makeyes2/PPM-ECE455-SP26/SP26_Magnetometer1_CoilDesignFiles_TylerFisher/SP26_Magnetometer1_CoilCalculations_TylerFisher.xlsx

Sheet: Solenoid
Input Values: |  | Constants |  | Intermediate Values
 |  |  |  |  | Manuf Estimate: | Theoretical:
Wire Radius (m) | 0.00064 | Copper Resistivity | 1.73e-08 | Coil Resistance | 8.33 | 8.33
Num Turns (theoretical) | 795.7747155 | Madison Larmor Frequency | 2273.68 | Solenoid Volume | 0.001767145868
Solenoid Length (m) | 0.225 | Mu Naught | 1.25663e-06 | Filling Factor of Solenoid | 0.7293835486
Solenoid Rad (m) | 0.05 | Chi Value DI Water | 4.015e-09 | Length of (1) Coil Wire (m) | 250
Voltage | 60
Bandwidth | 200
Outputs Values:
Signal Strength (V) |  | 9.420135823e-07
Signal Noise (V) |  | 5.265349561e-09
S/N Ratio |  | 178.91

Sheet: Toroid
Input Values: |  | Constants |  | Intermediate Values
Wire Radius (m) |  | Copper Resistivity | 1.73e-08 | Coil Resistance | 9.53 | ROUGH ESTIM | 18 gauge
Num Turns | 5000 | Madison Larmor Frequency | 2273.68 | Toroid Volume (mL) | 1542.125688
Toroid L Diam | 0.25 | Mu Naught | 1.25663e-06
Toroid Cros Rad | 0.03 | Chi Value DI Water | 4.015e-09 | Length of Wire Coil Approx (m) | 942.4777961
Voltage | 12 | Magnetic Moment Proton | 1.410606795e-26 | Protons per cubic meter | 6.65336e+28
Bandwidth | 200 | Boltzman's Constant | 1.38e-23
Toroid Wall Wid | 0.005 | Water Fluid Density (kg/m3) | 1000
Fluid Temp (K) | 293 | Water Atomic Weight (amu) | 18
Outputs Values:
Signal Strength |  | 9.325829573e-07 | Actual strength is * (2 - sin^2 alpha), this is assuming best case angle
Signal Noise |  | 5.632785527e-09
S/N Ratio |  | 165.56
