makeyes2/PPM-ECE455-SP26/SP26_Magnetometer1_CoilDesignFiles_TylerFisher/SP26_Magnetometer1_ExtraPlateSTL_TylerFisher.stl

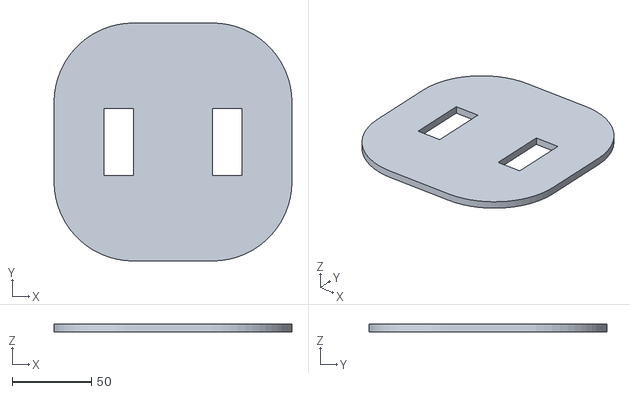
[picture p2: CAD file, 2026-05-05]
SP26_Magnetometer1_CoilDesignFiles_TylerFisher/SP26_Magnetometer1_ExtraPlateSTL_TylerFisher.stl
150.0 x 150.0 x 5.00
