makeyes2/PPM-ECE455-SP26/SP26_Magnetometer1_CoilDesignFiles_TylerFisher/SP26_Magnetometer1_TorusSTL_TylerFisher.stl

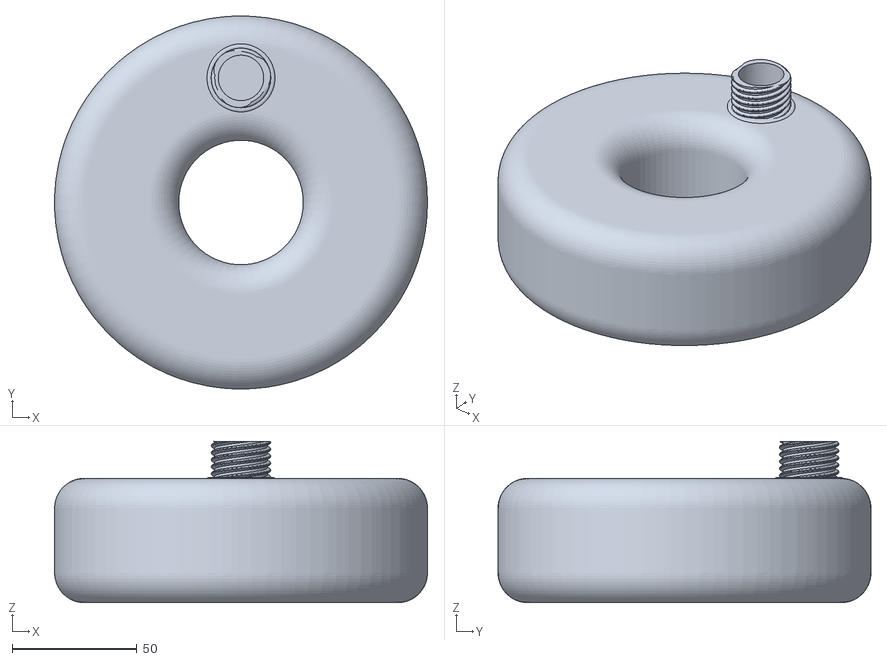
[picture p3: CAD file, 2026-05-05]
SP26_Magnetometer1_CoilDesignFiles_TylerFisher/SP26_Magnetometer1_TorusSTL_TylerFisher.stl
149.7 x 149.7 x 64.8
