makeyes2/PPM-ECE455-SP26/SP26_Magnetometer1_CoilDesignFiles_TylerFisher/SP26_Magnetometer1_ExtraBaseplateSTL_TylerFisher.stl

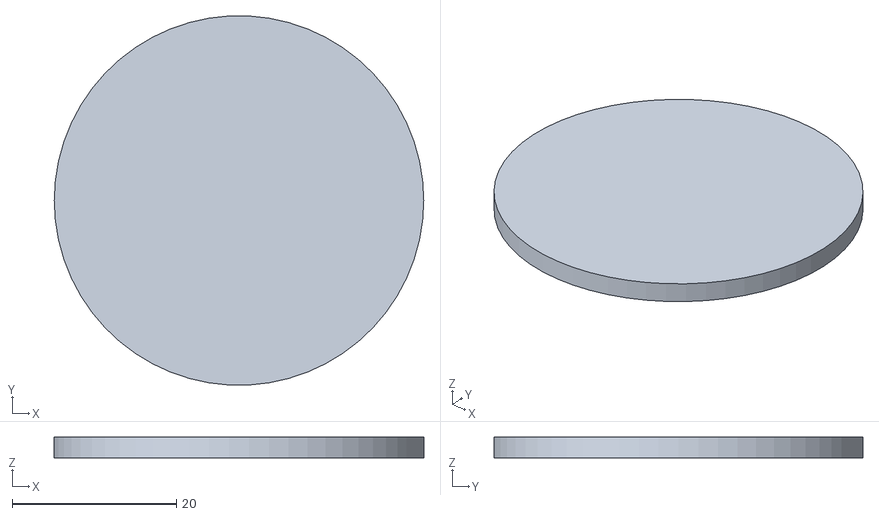
[picture p4: CAD file, 2026-05-05]
SP26_Magnetometer1_CoilDesignFiles_TylerFisher/SP26_Magnetometer1_ExtraBaseplateSTL_TylerFisher.stl
45.0 x 44.9 x 2.50
