makeyes2/PPM-ECE455-SP26/SP26_Magnetometer1_CoilDesignFiles_TylerFisher/SP26_Magnetometer1_PolarizationCoilandBase_TylerFisher.stl

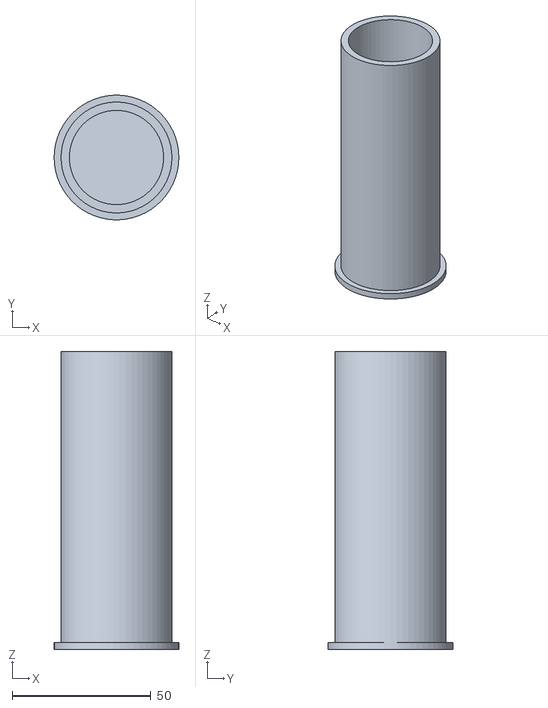
[picture p5: CAD file, 2026-05-05]
SP26_Magnetometer1_CoilDesignFiles_TylerFisher/SP26_Magnetometer1_PolarizationCoilandBase_TylerFisher.stl
45.0 x 44.9 x 107.5
