makeyes2/PPM-ECE455-SP26/SP26_Magnetometer1_CoilDesignFiles_TylerFisher/SP26_Magnetometer1_ThreadedCapandLidSTL_TylerFisher.stl

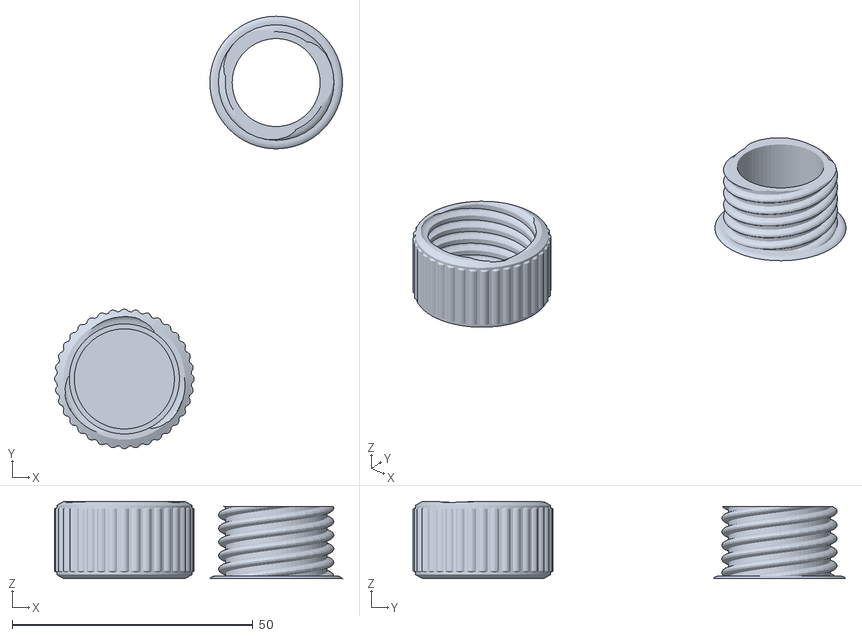
[picture p6: CAD file, 2026-05-05]
SP26_Magnetometer1_CoilDesignFiles_TylerFisher/SP26_Magnetometer1_ThreadedCapandLidSTL_TylerFisher.stl
59.8 x 89.8 x 16.0
