makeyes2/PPM-ECE455-SP26/(list of files, cad)

Other CAD files:
SP26_Magnetometer1_CoilDesignFiles_TylerFisher/SP26_Magnetometer1_TorusGCode_TylerFisher.3mf
SP26_Magnetometer1_CoilDesignFiles_TylerFisher/SP26_Magnetometer1_SensorCoilandPlateGCode_TylerFisher.3mf
SP26_Magnetometer1_CoilDesignFiles_TylerFisher/SP26_Magnetometer1_ExtraBaseplateGCode_TylerFisher.3mf
SP26_Magnetometer1_CoilDesignFiles_TylerFisher/SP26_Magnetometer1_PolarizationCoilandBaseGCode_TylerFisher.3mf
