makeyes2/PPM-ECE455-SP26/SP26_Magnetometer1_Amplification_Circuit_Schematic_Jack_Minton.pdf

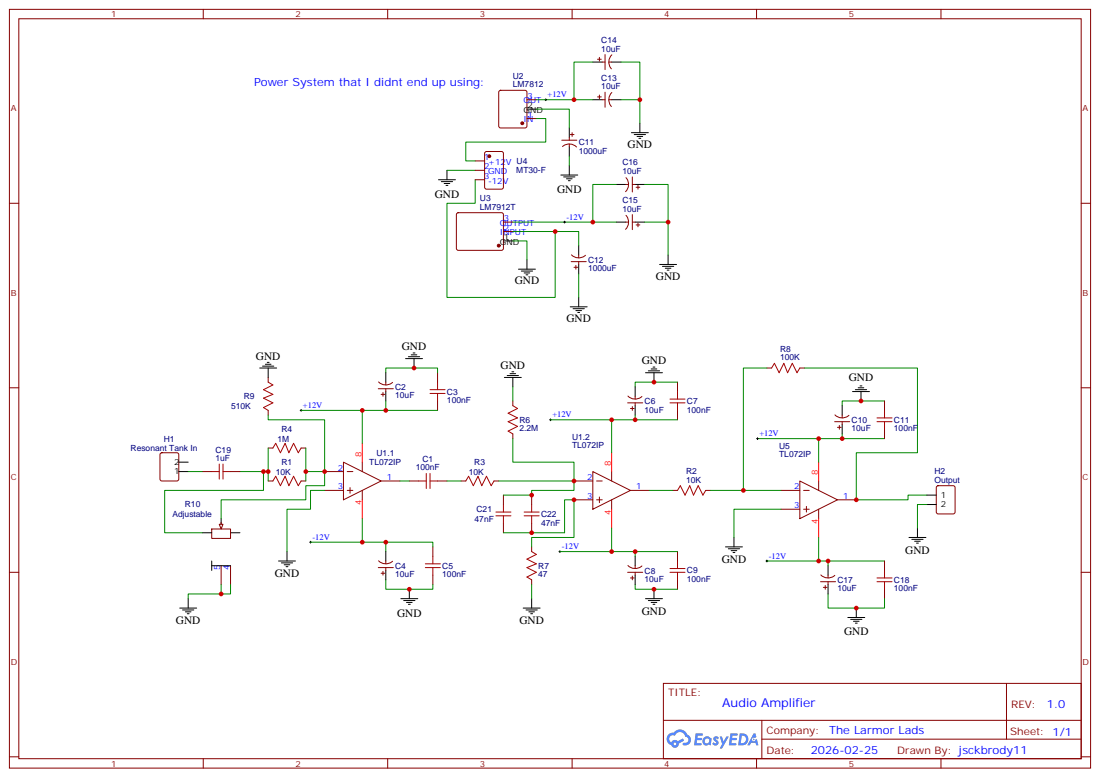
[picture p7: page 1]

Power System that I didnt end up using:

Company: The Larmor Lads
