makeyes2/PPM-ECE455-SP26/(commit log)

2026-05-04 Frequency PCB files
2026-05-04 reset FPGA after error state
    [FrequencyDetector.ino]
